smit2400/Mechatronics-Kit/hardware/l293d-motor-driver/rev1/L293d.kicad_pcb

## KiCad design hardware/l293d-motor-driver/rev1/L293d.kicad_pcb (2026-11-07, an earlier design)

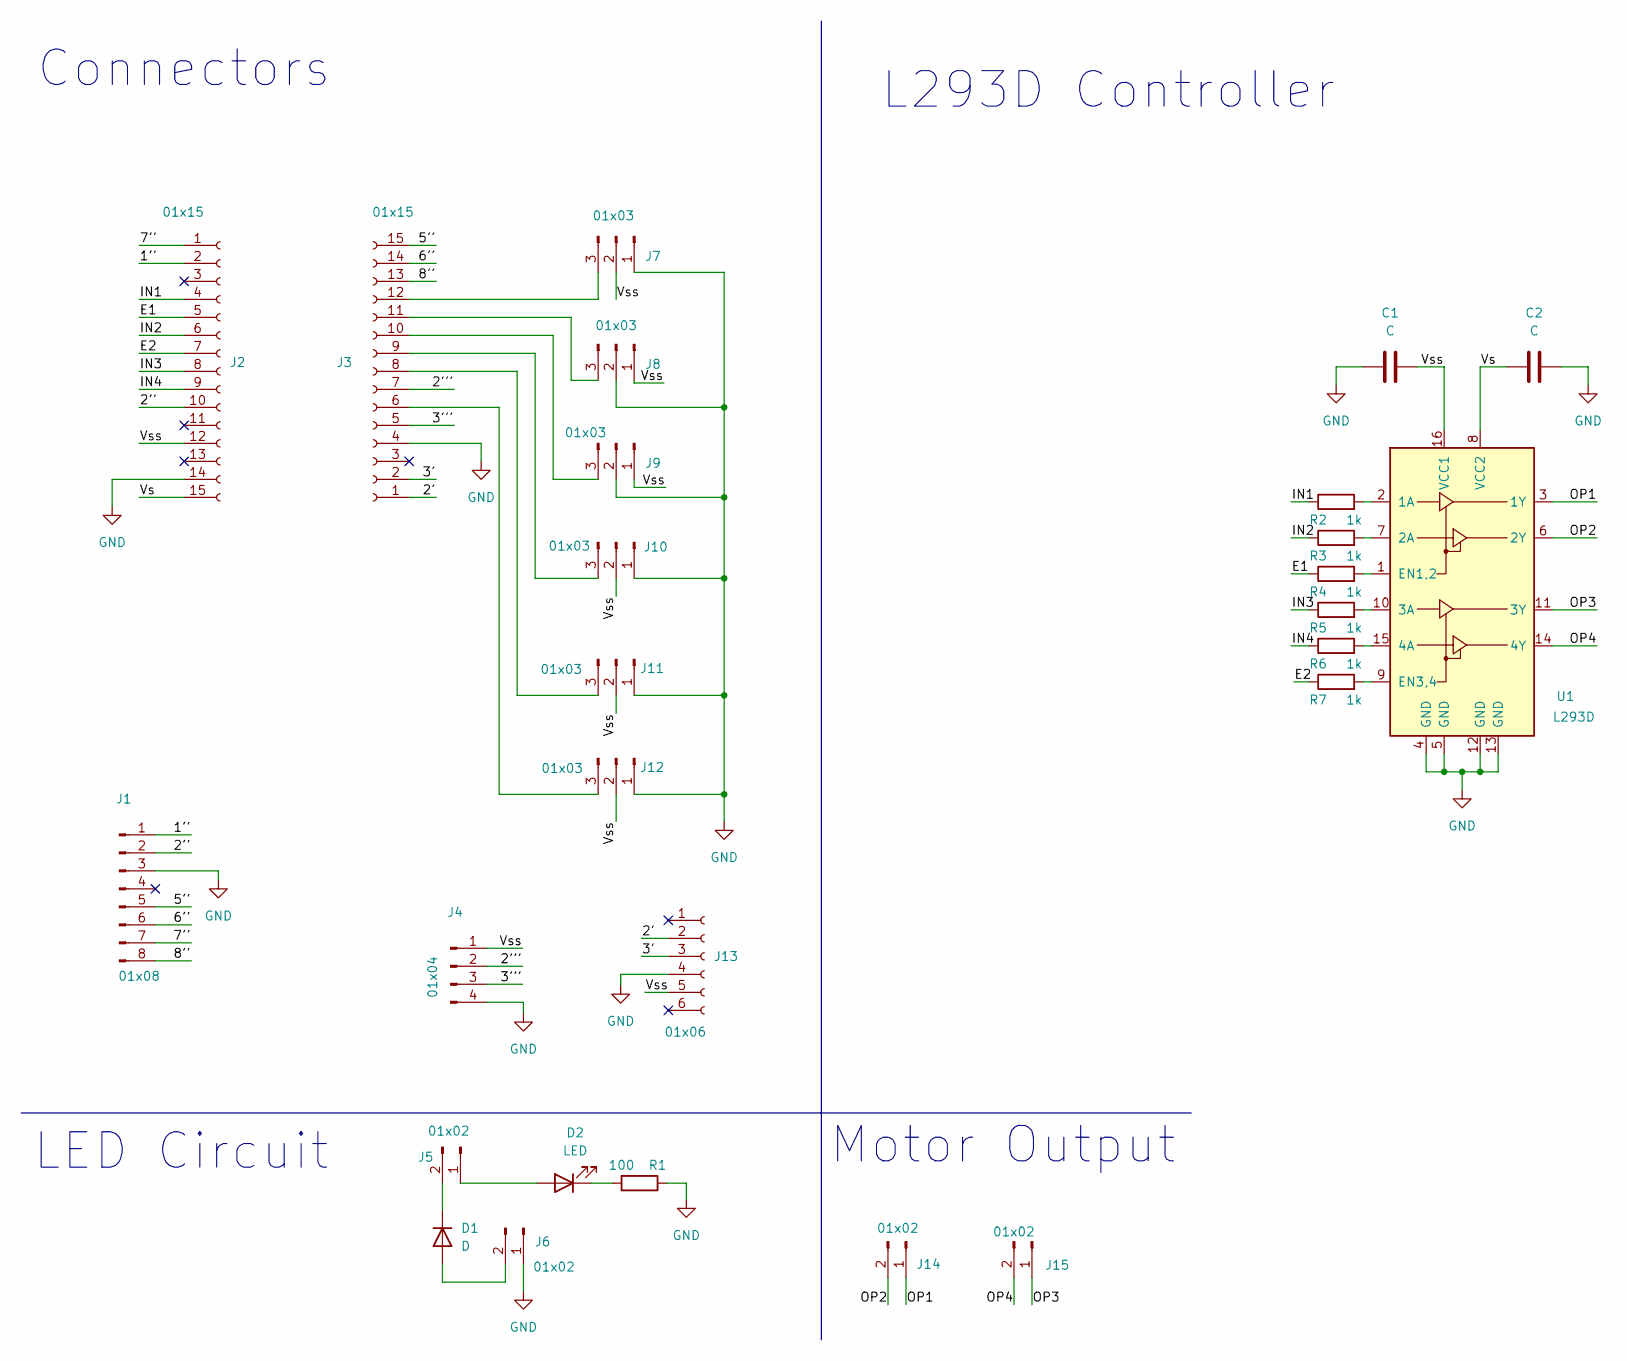
[picture p4: schematic L293d.kicad_sch, L293d Breakout board]

Parts:
C1, C2: C; C_0805_2012Metric
D1: D; D_SMA
D2: LED; LED_1206_3216Metric
J1: 01x08; PinHeader_1x08_P2.54mm_Vertical
J2, J3: 01x15; PinHeader_1x15_P2.54mm_Vertical
J4: 01x04; PinHeader_1x04_P2.54mm_Vertical
J5: 01x02; PinHeader_1x02_P2.54mm_Vertical
J6: 01x02; JST_EH_B2B-EH-A_1x02_P2.50mm_Vertical
J7, J8, J9, J10, J11, J12: 01x03; PinHeader_1x03_P2.54mm_Vertical
J13: 01x06; PinHeader_1x06_P2.54mm_Vertical
J14, J15: 01x02; JWT_A3963_1x02_P3.96mm_Vertical
R1: 100; R_0805_2012Metric
R2, R3, R4, R5, R6, R7: 1k; R_0805_2012Metric
U1: L293D; DIP-16_W7.62mm

Connections:
/1'': J1.1, J2.2
/2': J3.1, J13.2
/2'': J1.2, J2.10
/2''': J3.7, J4.2
/3': J3.2, J13.3
/3''': J3.5, J4.3
/5'': J1.5, J3.15
/6'': J1.6, J3.14
/7'': J1.7, J2.1
/8'': J1.8, J3.13
/E1: J2.5, R4.1
/E2: J2.7, R7.1
/IN1: J2.4, R2.1
/IN2: J2.6, R3.1
/IN3: J2.8, R5.1
/IN4: J2.9, R6.1
/OP1: J14.1, U1.3 (1Y)
/OP2: J14.2, U1.6 (2Y)
/OP3: J15.1, U1.11 (3Y)
/OP4: J15.2, U1.14 (4Y)
/Vs: C2.1, J2.15, U1.8 (VCC2)
/Vss: C1.1, J2.12, J4.1, J7.2, J8.1, J9.1, J10.2, J11.2, J12.2, J13.5, U1.16 (VCC1)
GND: C1.2, C2.2, J1.3, J2.14, J3.4, J4.4, J6.1, J7.1, J8.2, J9.2, J10.1, J11.1, J12.1, J13.4, R1.1, U1.4 (GND), U1.5 (GND), U1.12 (GND), U1.13 (GND)
unnamed: D1.1 (K), J5.2
unnamed: D1.2 (A), J6.2
unnamed: D2.1 (K), R1.2
unnamed: D2.2 (A), J5.1
unnamed: J3.10, J9.3
unnamed: J3.11, J8.3
unnamed: J3.12, J7.3
unnamed: J3.9, J10.3
unnamed: J3.8, J11.3
unnamed: J3.6, J12.3
unnamed: R2.2, U1.2 (1A)
unnamed: R3.2, U1.7 (2A)
unnamed: R4.2, U1.1 (EN1,2)
unnamed: R5.2, U1.10 (3A)
unnamed: R6.2, U1.15 (4A)
unnamed: R7.2, U1.9 (EN3,4)

Notes on the sheet:
Motor Output
L293D Controller
Connectors
LED Circuit

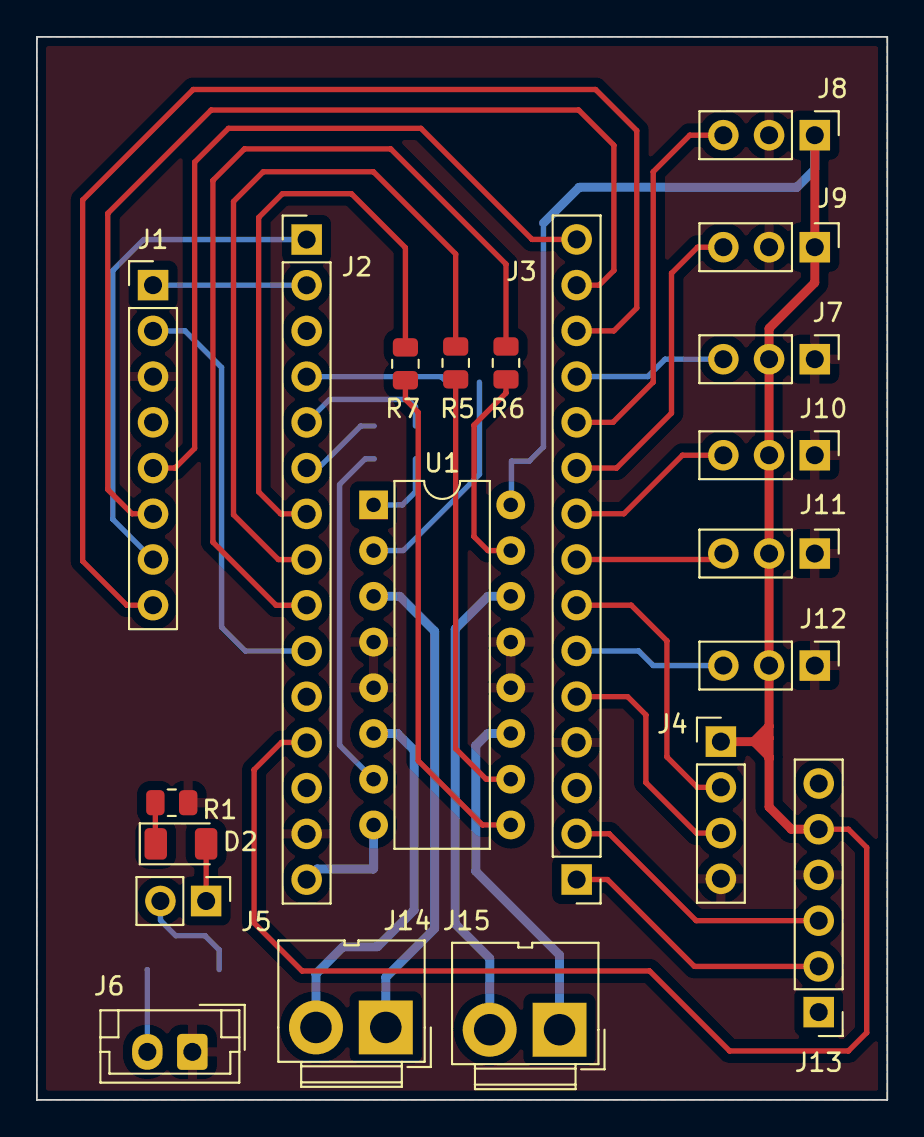
[picture p5: board L293d.kicad_pcb from above]

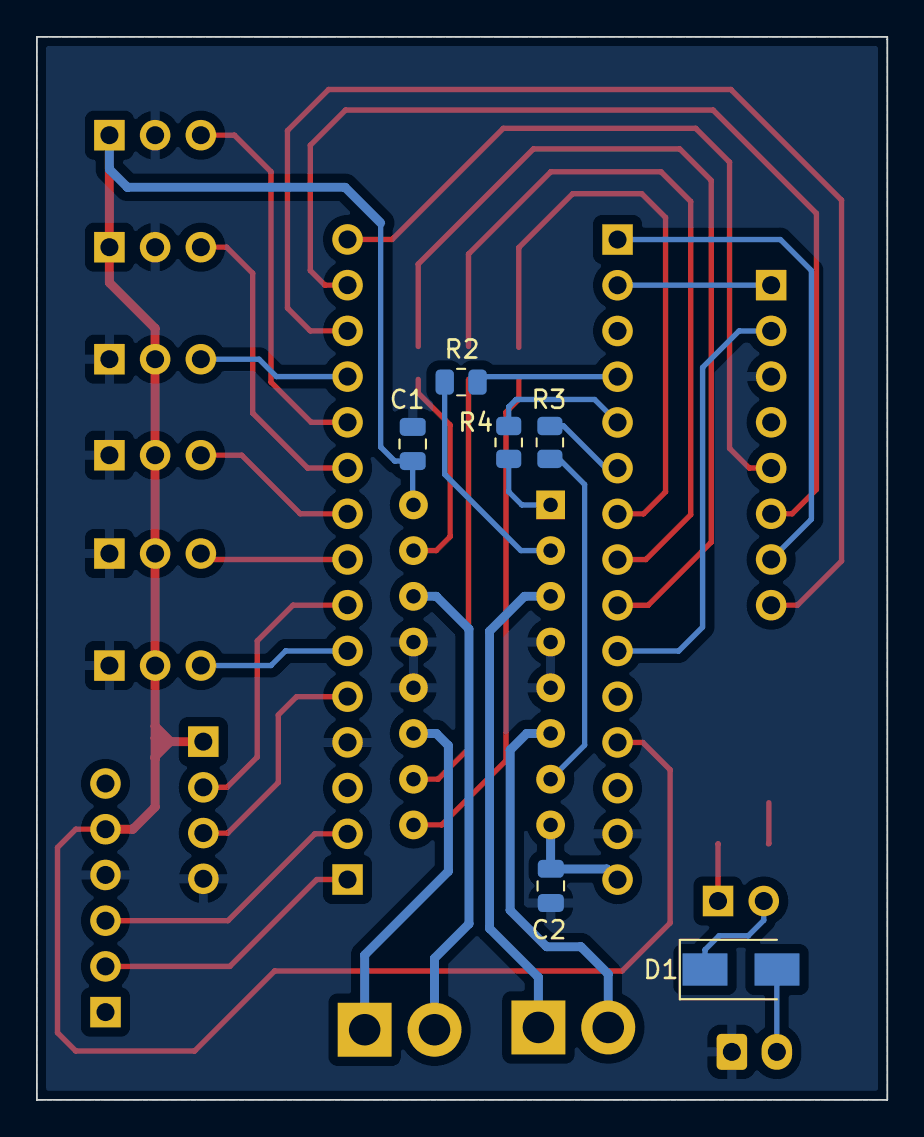
[picture p6: board L293d.kicad_pcb from below]

Board: 2 copper layers, 47.2 x 59.1 mm, 27 parts (6 on the bottom side), 39 nets.
