smit2400/Mechatronics-Kit/hardware/otto-controller/otto.kicad_pcb

## KiCad design hardware/otto-controller/otto.kicad_pcb (2026-11-07)

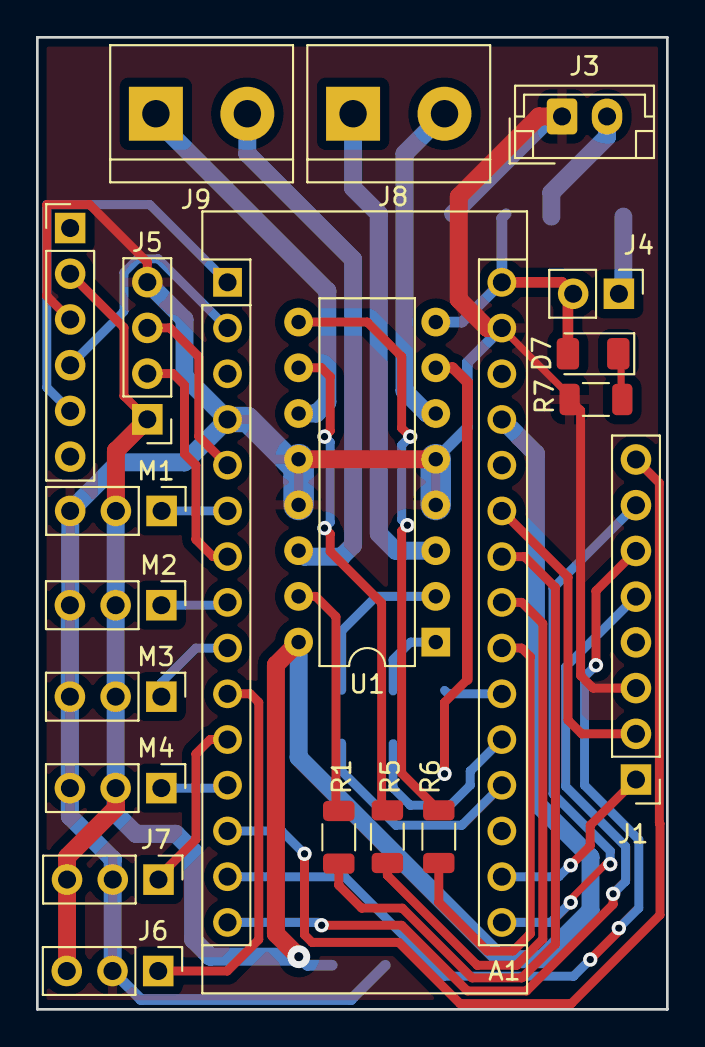
[picture p7: board otto.kicad_pcb from above]

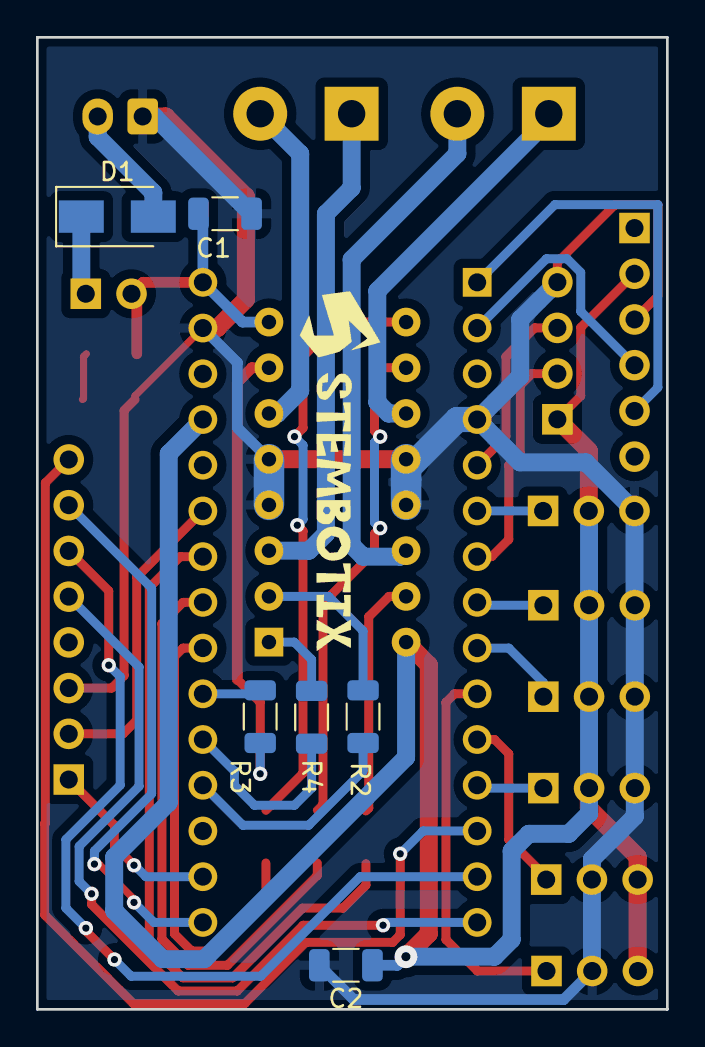
[picture p8: board otto.kicad_pcb from below]

Board: 2 copper layers, 35.0 x 54.0 mm, 25 parts (6 on the bottom side), 36 nets.

Parts:
A1: Arduino_Nano_Every; Arduino_Nano
C1, C2: 100uF; C_1206_3216Metric
D1: M7; D_SMA
D7: LED; LED_1206_3216Metric
J1: RFID_module; PinHeader_1x08_P2.54mm_Vertical
J3: Battery; JST_EH_B2B-EH-A_1x02_P2.50mm_Vertical
J4: POWER; PinHeader_1x02_P2.54mm_Vertical
J5: Ultrasonic; PinHeader_1x04_P2.54mm_Vertical
J6: IR1; PinHeader_1x03_P2.54mm_Vertical
J7: IR2; PinHeader_1x03_P2.54mm_Vertical
J8: Motor1; TerminalBlock_bornier-2_P5.08mm
J9: Motor2; TerminalBlock_bornier-2_P5.08mm
M1: Servo1; PinHeader_1x03_P2.54mm_Vertical
M2: Servo2; PinHeader_1x03_P2.54mm_Vertical
M3: Servo3; PinHeader_1x03_P2.54mm_Vertical
M4: Servo4; PinHeader_1x03_P2.54mm_Vertical
R1, R2, R3, R4, R5, R6, R7: R; R_1206_3216Metric
U1: L293D; DIP-16_W7.62mm

Connections:
/1A: A1.19 (A0), R2.2
/2A: A1.21 (A2), R3.2
/3A: A1.23 (SDA/A4), R5.2
/4A: A1.24 (SCL/A5), R1.2
/CS_RFID: A1.13 (D10), J1.8
/ECHO: A1.5 (D2), J5.3
/EN12: A1.20 (A1), R4.2
/EN34: A1.22 (A3), R6.2
/IR1: A1.10 (D7), J6.1
/IR2: A1.11 (D8), J7.1
/MISO: A1.15 (MISO), J1.5
/MOSI: A1.14 (MOSI), J1.6
/RST_RFID: A1.25 (A6), J1.2
/SCK: A1.16 (SCK), J1.7
/SERVO1: A1.6 (D3), M1.1 (PWM)
/SERVO2: A1.8 (D5), M2.1 (PWM)
/SERVO3: A1.9 (D6), M3.1 (PWM)
/SERVO4: A1.12 (D9), M4.1 (PWM)
/TRIG: A1.7 (D4), J5.2
/V3.3: A1.17 (3V3), J1.1
/VIN: A1.30 (VIN), C1.1, D7.2 (A), J4.2, U1.8 (VCC2)
GNDREF: A1.4 (GND), A1.29 (GND), C1.2, C2.2, J1.3, J3.1, J5.4, J6.2, J7.2, M1.3 (-), M2.3 (-), M3.3 (-), M4.3 (-), R7.1, U1.4 (GND), U1.5 (GND), U1.12 (GND), U1.13 (GND)
unnamed: D1.1 (K), J4.1
unnamed: D1.2 (A), J3.2
unnamed: D7.1 (K), R7.2
unnamed: J8.1, U1.3 (1Y)
unnamed: J8.2, U1.6 (2Y)
unnamed: J9.1, U1.11 (3Y)
unnamed: J9.2, U1.14 (4Y)
unnamed: R1.1, U1.15 (4A)
unnamed: R2.1, U1.2 (1A)
unnamed: R3.1, U1.7 (2A)
unnamed: R4.1, U1.1 (EN1,2)
unnamed: R5.1, U1.10 (3A)
unnamed: R6.1, U1.9 (EN3,4)
VCC: A1.27 (+5V), C2.1, J5.1, J6.3, J7.3, M1.2 (+), M2.2 (+), M3.2 (+), M4.2 (+), U1.16 (VCC1)
