smit2400/Mechatronics-Kit/firmware/sensor-tests/pir_motion/pir_motion.ino

int led = 13;                // the pin that the LED is atteched to
int sensor = 4;              // the pin that the sensor is atteched to
int state = LOW;             // by default, no motion detected
int val = 0;                 // variable to store the sensor status (value)

void setup() {
  pinMode(led, OUTPUT);      // initalize LED as an output
  pinMode(sensor, INPUT);    // initialize sensor as an input
  Serial.begin(9600);        // initialize serial
}

void loop(){
  val = digitalRead(sensor);   // read sensor value

  if (val == HIGH) {           // check if the sensor is HIGH
    digitalWrite(led, HIGH);   // turn LED ON
    delay(500);                // delay 100 milliseconds 
    
    if (state == LOW) {
      Serial.println("Motion detected!"); 
      state = HIGH;       // update variable state to HIGH
    }
  } 
  else {
      digitalWrite(led, LOW); // turn LED OFF
      delay(500);             // delay 200 milliseconds 
      
      if (state == HIGH){
        Serial.println("Motion stopped!");
            int i=i+1;
  Serial.println(i);
        state = LOW;       // update variable state to LOW
    }
  }
}
